pappyjoe16/Pumping_Machine_Controller/README.md

# Pumping_Machine_Controller
Project monitors the level of water to control pumping machine wither to ON or OFF
The project monitors the level of water in the tank using ultrasonic sensons, base on the the level 
of water the system decide when to ON the pumping Machine or OFF it.
