pappyjoe16/Pumping_Machine_Controller/(list of files, drawings)

Other design files:
New Water Level/Design/completed NewDesignWater.pdsprj
