pappyjoe16/Pumping_Machine_Controller/instructions _to _commit_and_push _to_github_from_vsCode.odt

Introduction to Github.

Origin – this refers to a centralized repository where you put your code. It’s the origin where other people can also go and get a copy of that code.

Master – Master is not the same as origin, rather it is a copy of the origin.

Branch – this is like a side detour where a copy of the original code is worked upon without affecting the original code. This can be to fix a bug or add new features to the original code and have it tested separately without affecting the original code. After the bugs must have been fixed and or new features working fine that the branch can be marge with the original code.

Commit - committing is the process which records changes in the repository. Think of it as a snapshot of the current status of the project. Commits are done locally.

Commit is like a version created every time yo make and a new edition on your code (add new features to the code)

Push - pushing sends the recent commit history from your local repository up to GitHub. If you're the only one working on a repository, pushing is fairly simple. If there are others accessing the repository, you may need to pull before you can push.

Pull - a pull grabs any changes from the GitHub repository and merges them into your local repository.

Sync - syncing is like pulling, but instead of connecting to your GitHub copy of the forked repo, it goes back to the original repository and brings in any changes. Once you've synced your repository, you need to push those changes back to your GitHub account.

Clone – this is copying a copy of the entire repository on the github account to save it on your local machine.

To commit and push to git hub repository :

1. First go to the github site and create the repository.

2. copy the URL of github account

3. Open Open your VsCode software

4. Click on clone a repository and enter the URL of the github account you want to clone from.

5. (The repositories present in that github account will show) then choose the repository you want to clone.

6. chose where you want to save the cloned file on your local machine, then save.

7a. If the file is already existing in a folder from the clone repository, then open it to make your comment and save

7b. If the file does not exist on the cloned repository, then create and save.

8. Click on the version control icon

9. A folder or path called changes will appear consisting the file you just saved (the file to be committed and push to github). Right click on the file and click on “stage changes”(Stage changes is you preparing the file to be committed). Anew folder or path then appear, Now you can add your commit message (such as first commit or something more specific, something that convey features or bugs you have included)….. Note: This is very important for you to be able to track the progress of your work

10. Now you can click on the commit button (The mark or tick sign).

Now you have successfully commit your first task. Note this is still on your local machine to push it to github repository follow the next line of instructions.

11. To Push the commit to the github repository then click on the 3 dots and click “push”

Now you can go refresh the github page and the file will be there now.
